UrbanSmartGrid/T-LOG-Projects/PROJECTS/AD/T-LOG v2.0/T-LOG v2.0/Сборка.jpg

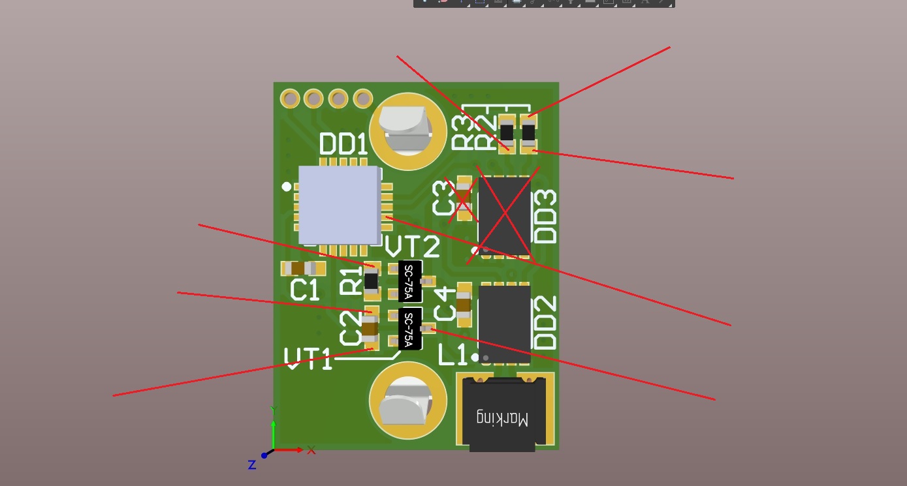
PROJECTS/AD/T-LOG v2.0/T-LOG v2.0/Сборка.jpg
