UrbanSmartGrid/T-LOG-Projects/Компоненты/E2PROM_NFC/ST/NFC_ePaper-master/NFC_ePaper-master/README.md

NFC based ePaper WorkCard
==========

This is an android app for a nfc based epaper workcard.

 

----

This software is written by Jack Shao (xuguang.shao@seeedstudio.com) for seeed studio<br>
and is licensed under [The MIT License](http://opensource.org/licenses/mit-license.php). Check License.txt for more information.<br>

Contributing to this software is warmly welcomed. You can do this basically by<br>
[forking](https://help.github.com/articles/fork-a-repo), committing modifications and then [pulling requests](https://help.github.com/articles/using-pull-requests) (follow the links above<br>
for operating guide). Adding change log and your contact into file header is encouraged.<br>
Thanks for your contribution.

Seeed Studio is an open hardware facilitation company based in Shenzhen, China. <br>
Benefiting from local manufacture power and convenient global logistic system, <br>
we integrate resources to serve new era of innovation. Seeed also works with <br>
global distributors and partners to push open hardware movement.<br>

Analytics (https://github.com/igrigorik/ga-beacon)
