UrbanSmartGrid/T-LOG-Projects/Картинки/Исходные/1.gif

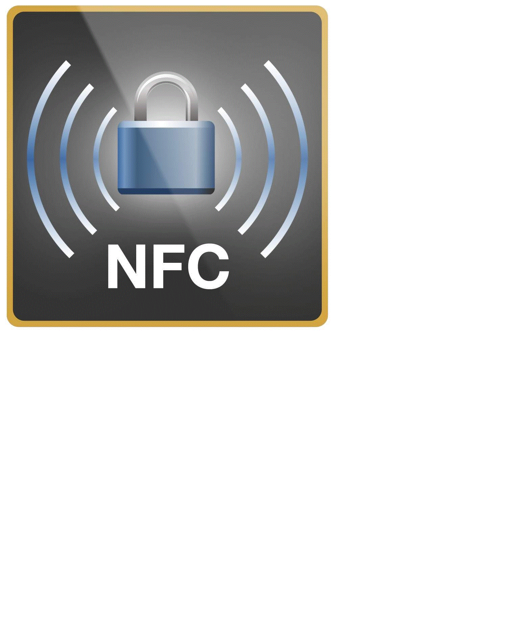
Картинки/Исходные/1.gif
