UrbanSmartGrid/T-LOG-Projects/PROJECTS/AD/T-LOG v2.0/T-LOG v2.0/Project Outputs for T-LOG v2.0/T-LOG v2.0_Designators.xlsx

Designator | Description
C1 | Чип-конденсатор 0,1 мкФ 50 В 0402
C2 | Чип-конденсатор 0,1 мкФ 50 В 0402
C3 | Чип-конденсатор 0,1 мкФ 50 В 0402
C4 | Чип-конденсатор 0,1 мкФ 50 В 0402
DD1 | Микроконтроллер AVR ATtiny406-MNR VQFN20
DD2 | Память EEPROM I2C/NFC 64Кбит M24LR64E-RMC6T UFDFN8 ST
DD3 | Память EEPROM I2C 64 Кбит AT24C64D‑MAHM UDFN8
L1 | Чип-индуктивность WE-LQ 744032004 4,7 мкГн 0,49 А Wurth Elektronik
R1 | Чип-резистор 4,7 кОм 5% 0402
R2 | Чип-резистор 4,7 кОм 5% 0402
R3 | Чип-резистор 4,7 кОм 5% 0402
VT1 | Транзистор MOSFET N-Channel NTA4001NT1G
VT2 | Транзистор MOSFET P-Channel NTA4151PT1G
X1 | Держатель элемента CR1025 KEYSTONE 3031
