UrbanSmartGrid/T-LOG-Projects/PROJECTS/AD/T-LOG v2.0/T-LOG v2.0/Project Outputs for T-LOG v2.0/T-LOG v2.0.xlsx

Description | Quantity
Чип-конденсатор 0,1 мкФ 50 В 0402 | 4
Микроконтроллер AVR ATtiny406-MNR VQFN20 | 1
Память EEPROM I2C/NFC 64Кбит M24LR64E-RMC6T UFDFN8 ST | 1
Память EEPROM I2C 64 Кбит AT24C64D‑MAHM UDFN8 | 1
Чип-индуктивность WE-LQ 744032004 4,7 мкГн 0,49 А Wurth Elektronik | 1
Чип-резистор 4,7 кОм 5% 0402 | 3
Транзистор MOSFET N-Channel NTA4001NT1G | 1
Транзистор MOSFET P-Channel NTA4151PT1G | 1
Держатель элемента CR1025 KEYSTONE 3031 | 1
