UrbanSmartGrid/T-LOG-Projects/Компоненты/BATTERY/Keystone_3031/keystone-PN3031.STEP

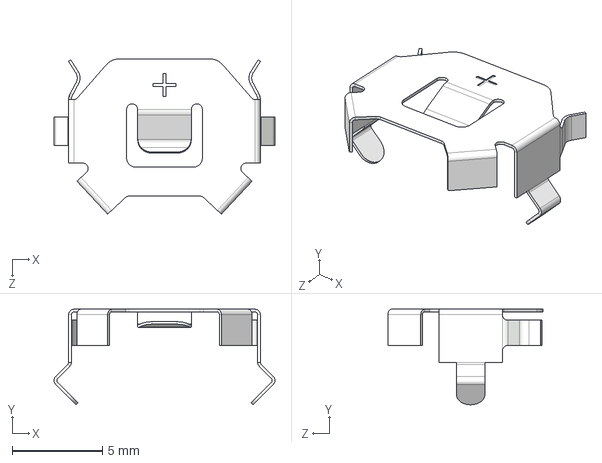
[picture p9: CAD file, 2021-01-24]
Компоненты/BATTERY/Keystone_3031/keystone-PN3031.STEP
12.2 x 5.29 x 8.59 mm
