UrbanSmartGrid/T-LOG-Projects/Компоненты/Диодные сборки/SOT-723.step

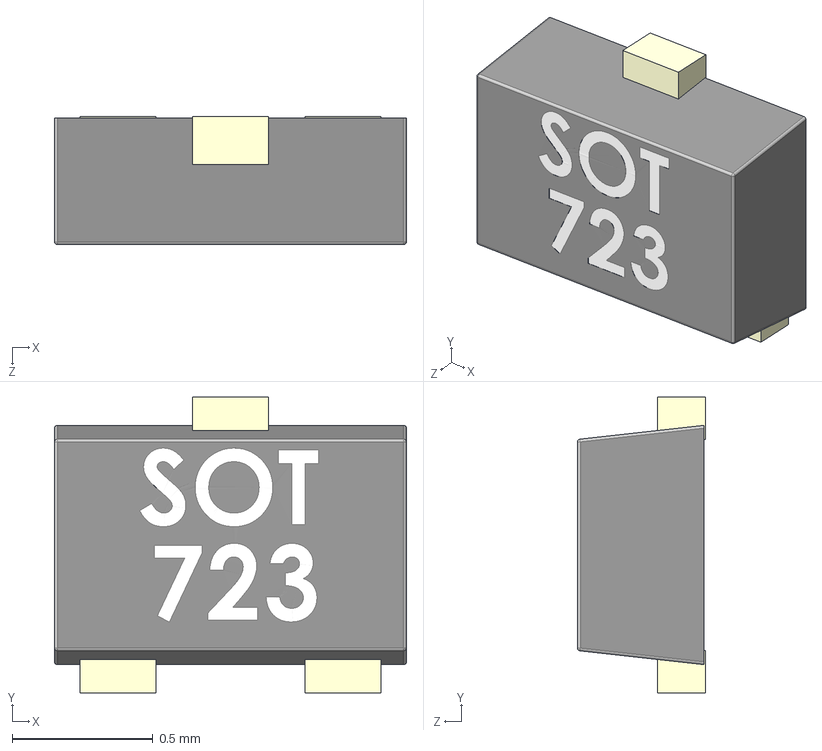
[picture p10: CAD file, 2021-01-24]
Компоненты/Диодные сборки/SOT-723.step
1.25 x 1.05 x 0.455 mm
