UrbanSmartGrid/T-LOG-Projects/Компоненты/E2PROM_NFC/ST/en.M24LR board Schematic.pdf

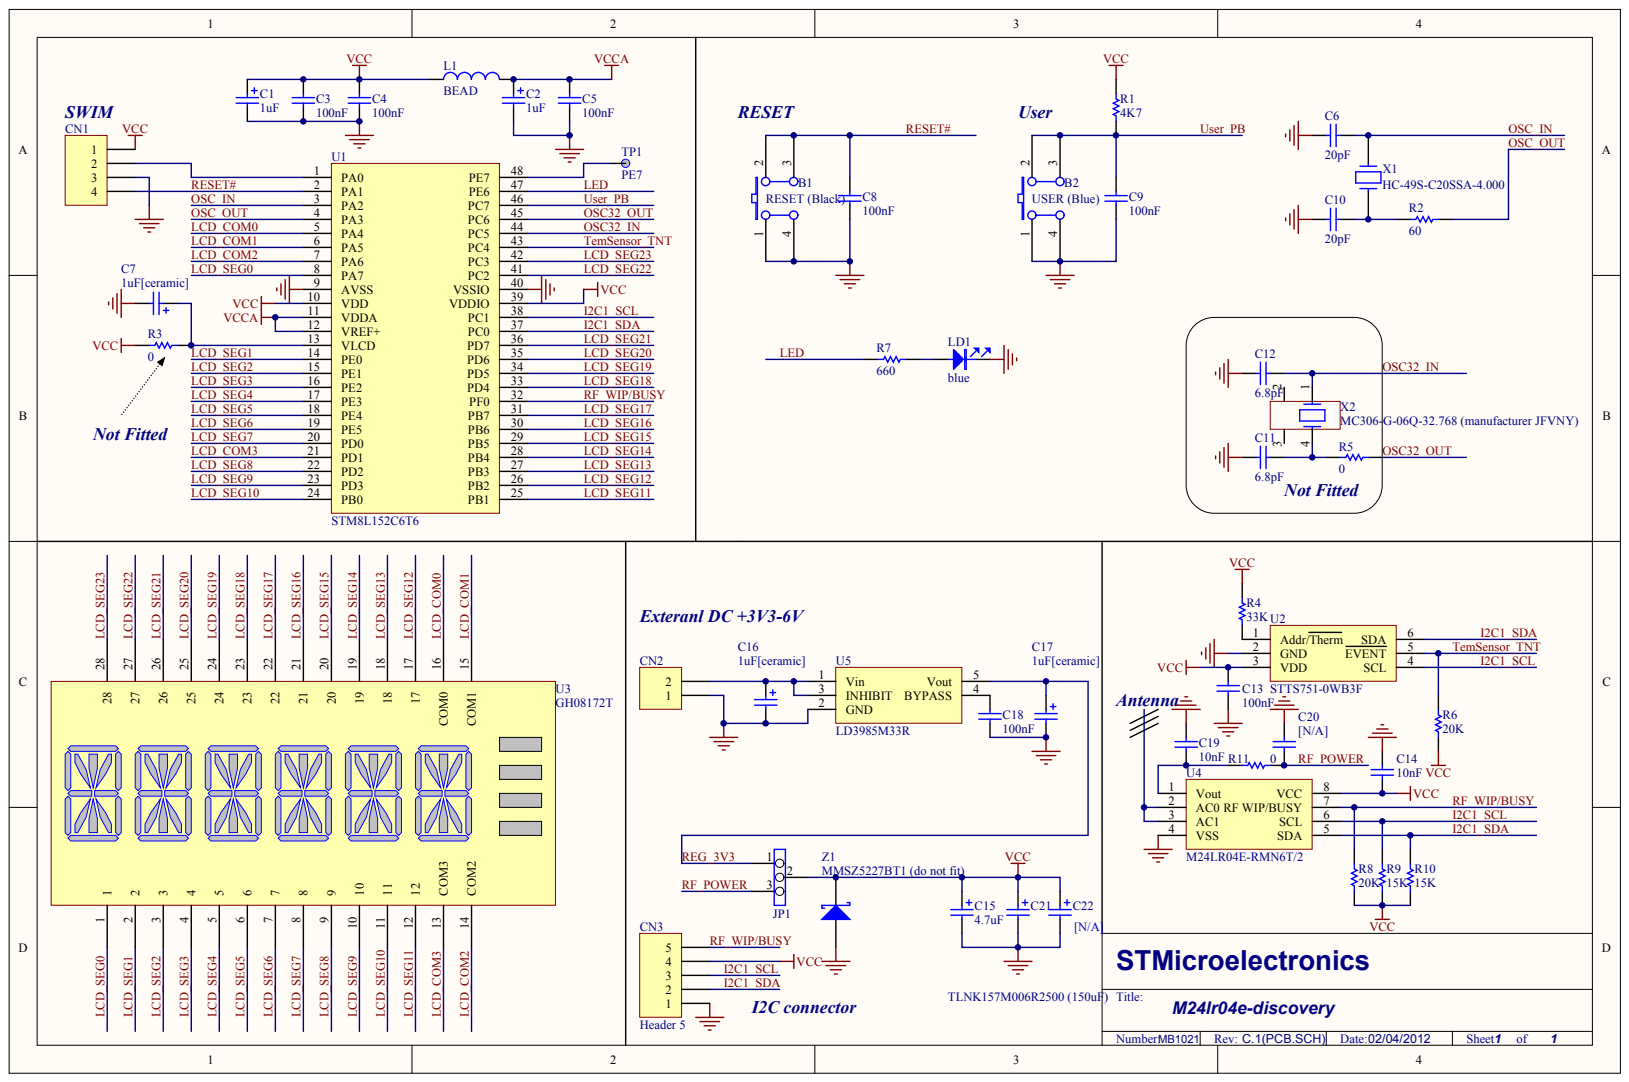
[picture p11: page 1]

RESET# | PA1 2
OSC_IN | PA2 3
