UrbanSmartGrid/T-LOG-Projects/(list of files, drawings)

Other design files:
PROJECTS/AD/T-LOG v1.0/T-LOG v1.0.PcbDoc
PROJECTS/AD/T-LOG v1.0/T-LOG v1.0.PrjPcb
PROJECTS/AD/T-LOG v1.0/T-LOG v1.0.SchDoc
PROJECTS/AD/T-LOG v1.1/T-LOG v1.1.PcbDoc
PROJECTS/AD/T-LOG v1.1/T-LOG v1.1.PrjPcb
PROJECTS/AD/T-LOG v1.1/T-LOG v1.1.SchDoc
PROJECTS/AD/T-LOG v2.0/T-LOG v2.0/T-LOG v2.0.PcbDoc
PROJECTS/AD/T-LOG v2.0/T-LOG v2.0/T-LOG v2.0.PrjPcb
PROJECTS/AD/T-LOG v2.0/T-LOG v2.0/T-LOG v2.0.SchDoc
PROJECTS/SOFT/STEND/DOC/STM3240G-EVAL/SCH/MB785A/MB785.PCBDOC
PROJECTS/SOFT/STEND/DOC/STM3240G-EVAL/SCH/MB785A/MB785.PrjPCB
PROJECTS/SOFT/STEND/DOC/STM3240G-EVAL/SCH/MB785A/MB785.SchDoc
PROJECTS/SOFT/STEND/DOC/STM3240G-EVAL/SCH/MB786C/Audio.SchDoc
PROJECTS/SOFT/STEND/DOC/STM3240G-EVAL/SCH/MB786C/Camera connector.SchDoc
PROJECTS/SOFT/STEND/DOC/STM3240G-EVAL/SCH/MB786C/CAN.SchDoc
PROJECTS/SOFT/STEND/DOC/STM3240G-EVAL/SCH/MB786C/Ethernet.SchDoc
PROJECTS/SOFT/STEND/DOC/STM3240G-EVAL/SCH/MB786C/ExtensionConnector.SchDoc
PROJECTS/SOFT/STEND/DOC/STM3240G-EVAL/SCH/MB786C/IO Peripherals.SchDoc
PROJECTS/SOFT/STEND/DOC/STM3240G-EVAL/SCH/MB786C/IO_Expandor.SchDoc
PROJECTS/SOFT/STEND/DOC/STM3240G-EVAL/SCH/MB786C/JTAG&Trace.SchDoc
PROJECTS/SOFT/STEND/DOC/STM3240G-EVAL/SCH/MB786C/LCD.SchDoc
PROJECTS/SOFT/STEND/DOC/STM3240G-EVAL/SCH/MB786C/MB786.SchDoc
PROJECTS/SOFT/STEND/DOC/STM3240G-EVAL/SCH/MB786C/MCU.SchDoc
PROJECTS/SOFT/STEND/DOC/STM3240G-EVAL/SCH/MB786C/MicroSDCard.SchDoc
PROJECTS/SOFT/STEND/DOC/STM3240G-EVAL/SCH/MB786C/MotorControl.SchDoc
PROJECTS/SOFT/STEND/DOC/STM3240G-EVAL/SCH/MB786C/Power.SchDoc
PROJECTS/SOFT/STEND/DOC/STM3240G-EVAL/SCH/MB786C/SmartCard.SchDoc
PROJECTS/SOFT/STEND/DOC/STM3240G-EVAL/SCH/MB786C/SRAM&OneNAND.SchDoc
PROJECTS/SOFT/STEND/DOC/STM3240G-EVAL/SCH/MB786C/ST_LINK.SCHDOC
PROJECTS/SOFT/STEND/DOC/STM3240G-EVAL/SCH/MB786C/USART&IrDA.SchDoc
PROJECTS/SOFT/STEND/DOC/STM3240G-EVAL/SCH/MB786C/USB_OTG_FS.SchDoc
PROJECTS/SOFT/STEND/DOC/STM3240G-EVAL/SCH/MB786C/USB_OTG_HS.SchDoc
